adafruit/Adafruit-Feather-RP2040-Adalogger-PCB/Adafruit Feather RP2040 Adalogger PrettyPins 2.pdf

# Adafruit Feather RP2040 Adalogger

# https://www.adafruit.com/product/5980

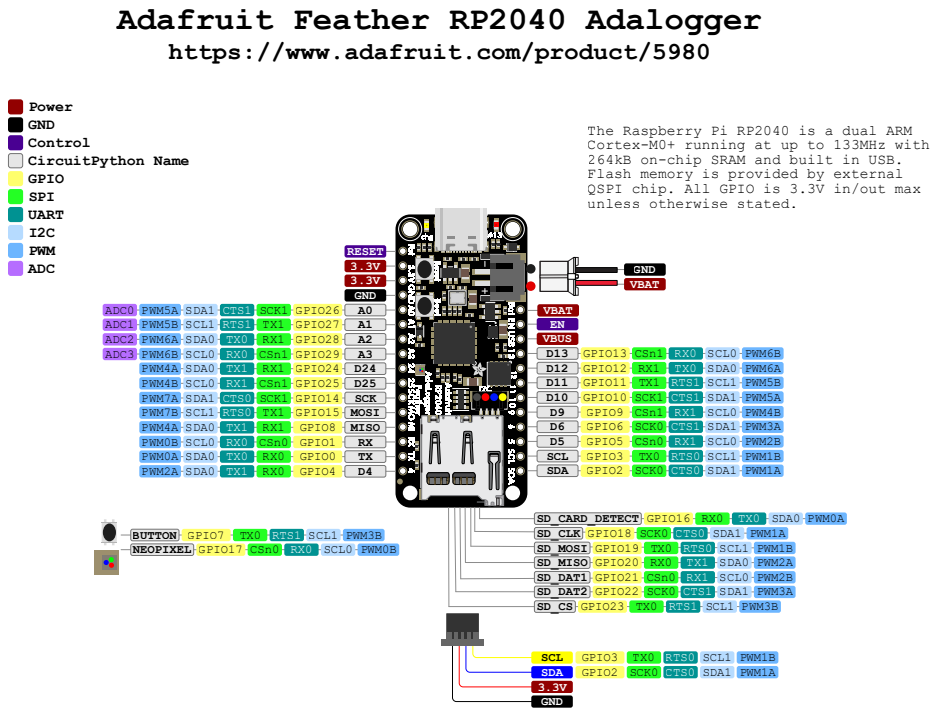
[picture p2: page 1]

The Raspberry Pi RP2040 is a dual ARM
Cortex-M0+ running at up to 133MHz with
264kB on-chip SRAM and built in USB.
Flash memory is provided by external
QSPI chip. All GPIO is 3.3V in/out max
unless otherwise stated.
